christyc14/EmotionWristband/README.md

# EmotionWristband

An emotion regulating wristband designed in 2016 for a robotics course, using the Arduino nano. 

Uses heart rate variability to detect when user is stressed, and then outputs a breathing exercise on the LED matrix to get the user to calm down. Stops when HRV is normal.
